MikeS11/MiSTerFPGA_YC_Encoder/Breakout Boards/BOM_JLCSMT_YC_Active_bbrd_1.0.xlsx

Comment | Designator | Footprint | JLCPCB Part #（optional）
100 nF | C1 | C0402 | C1525
150 pF | C11 | C0603 | C237333
100 nF | C2 | C0402 | C1525
0.1 nF | C3 | C0402 | C1546
100 nF | C4 | C0402 | C1525
470 pF | C5 | C0402 | C1537
82 pF | C6 | C0402 | C526982
10 pF | C7 | C0603 | C513681
Diode - 1N4148WS | D1 | SOD-323F | C2128
8.2 uH | L1 | L3225M | C295147
Dual N Type MOSFET | Q2 | SOT363 | C396098
91 | R1 | R0603 | C25199
422 | R10 | R0603 | C23170
1.4k | R15 | R0402 | C25867
10k | R16 | R0402 | C25744
10k | R17 | R0402 | C25744
100k | R18 | R0402 | C25741
10k | R2 | R0402 | C25744
75 | R3 | R0402 | C25133
75 | R4 | R0402 | C25133
75 | R5 | R0402 | C25133
75 | R6 | R0402 | C25133
430 | R7 | R0603 | C23170
160 | R8 | R0603 | C22814
820 | R9 | R0603 | C23253
N-Type MOSFET | T1 | SOT23 | C8545
BJT N-Type Dual | U2 | SOT65P210X110-6N | C513269
