MikeS11/MiSTerFPGA_YC_Encoder/Breakout Boards/YC_Active_bbrd_1.01.pdf

# MisterFPGA - Active YC Out Breakout Board Mike Simone - 2022

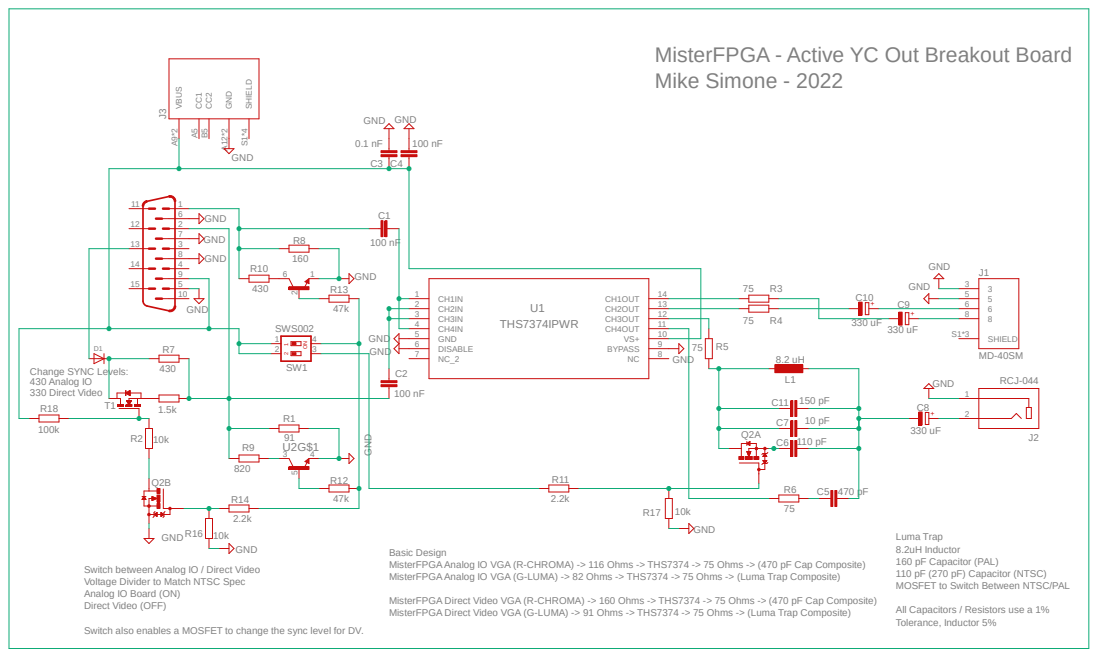
[picture p1: page 1]

Luma Trap
8.2uH Inductor
160 pF Capacitor (PAL)
110 pF (270 pF) Capacitor (NTSC)
MOSFET to Switch Between NTSC/PAL

Basic Design
MisterFPGA Analog IO VGA (R-CHROMA) -> 116 Ohms -> THS7374 -> 75 Ohms -> (470 pF Cap Composite)
MisterFPGA Analog IO VGA (G-LUMA) -> 82 Ohms -> THS7374 -> 75 Ohms -> (Luma Trap Composite)

Switch between Analog IO / Direct Video
Voltage Divider to Match NTSC Spec
Analog IO Board (ON)
Direct Video (OFF)

MisterFPGA Direct Video VGA (R-CHROMA) -> 160 Ohms -> THS7374 -> 75 Ohms -> (470 pF Cap Composite)
MisterFPGA Direct Video VGA (G-LUMA) -> 91 Ohms -> THS7374 -> 75 Ohms -> (Luma Trap Composite)

All Capacitors / Resistors use a 1%
Tolerance, Inductor 5%

Switch also enables a MOSFET to change the sync level for DV.

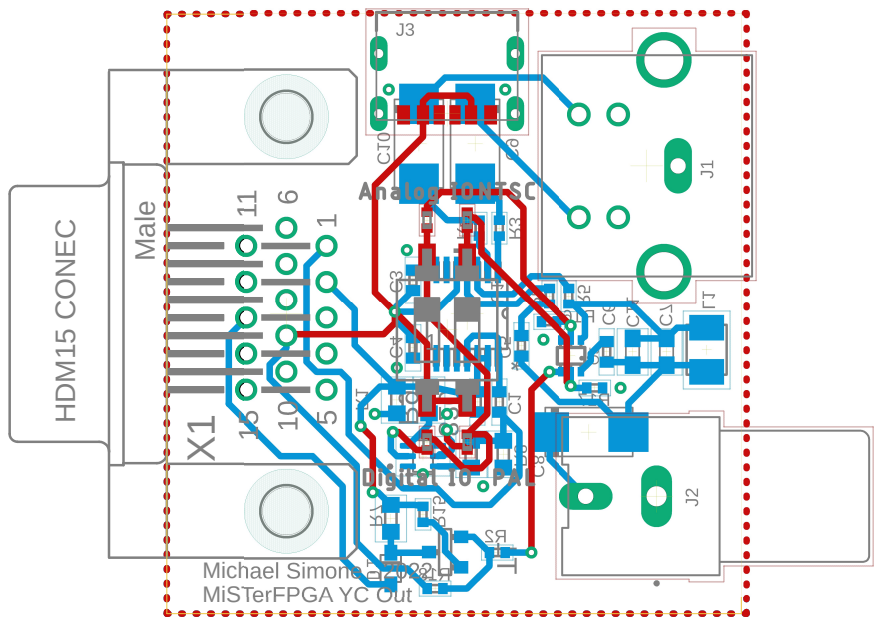
[picture p2: page 2]
15 11 Male HDM15 CONEC; Michael Simone - 2022

MiSTerFPGA YC Out X¹
