MikeS11/MiSTerFPGA_YC_Encoder/Breakout Boards/YCbbrd_1.01.pdf

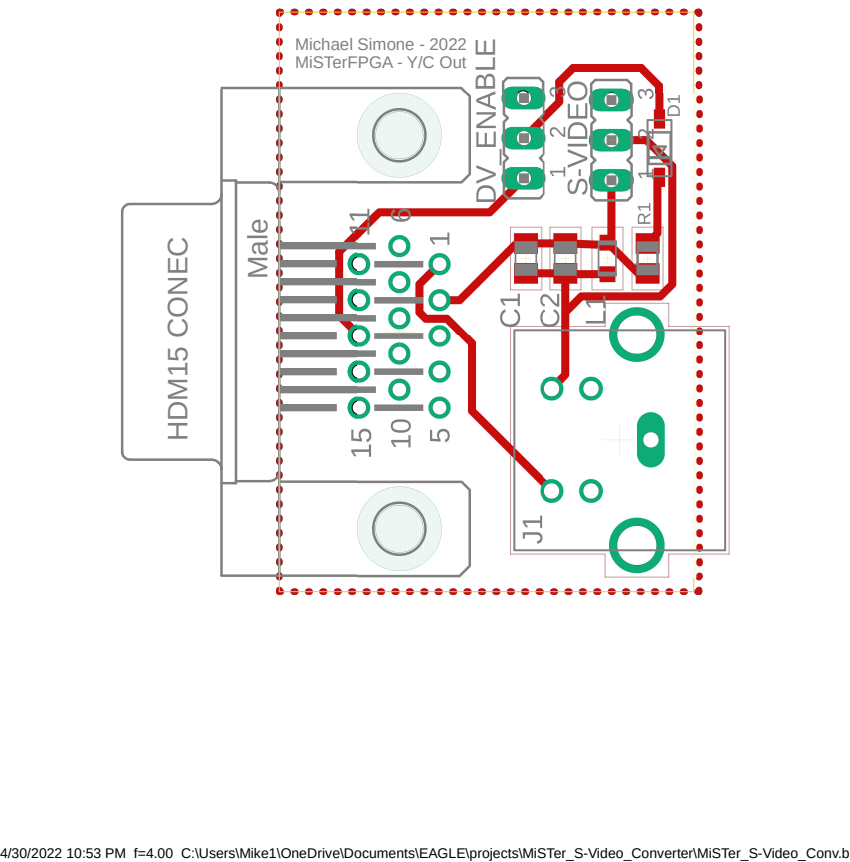
[picture p3: page 1]
3 3 HDM15 CONEC; Michael Simone - 2022 MiSTerFPGA - Y/C Out

4/30/2022 10:53 PM f=4.00 C:\Users\Mike1\OneDrive\Documents\EAGLE\projects\MiSTer_S-Video_Converter\MiSTer_S-Video_Conv.brd 15 11 Male

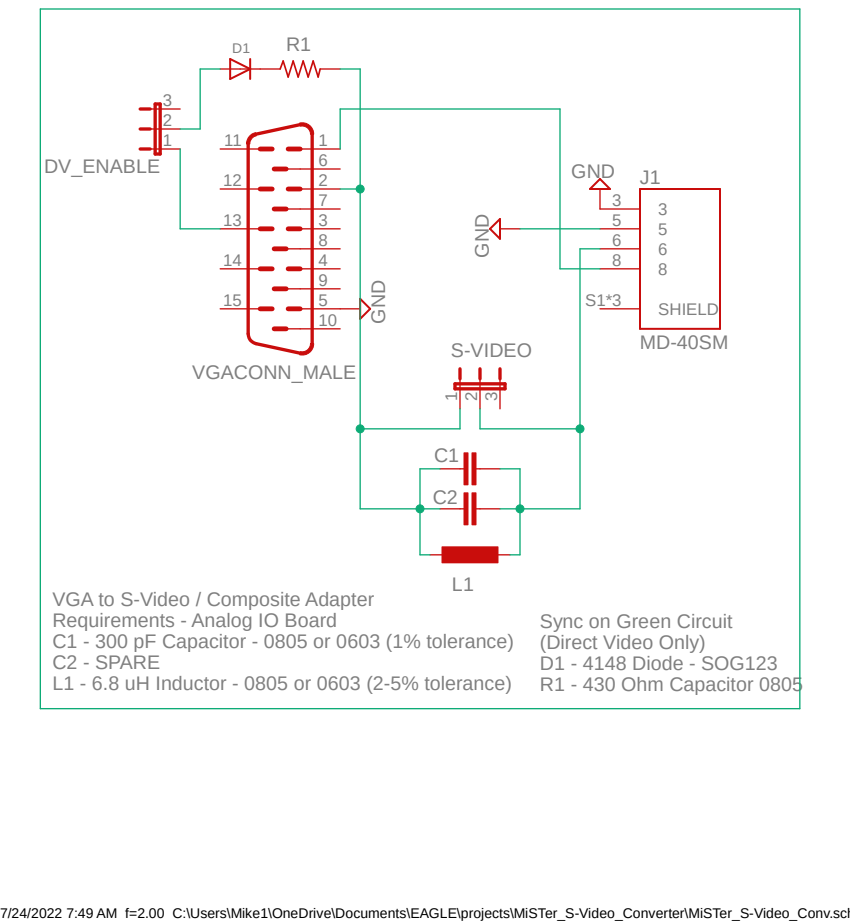
[picture p4: page 2]
MD-40SM GND; GND GND; SHIELD S1*3; VGACONN_MALE; DV_ENABLE; S-VIDEO

VGA to S-Video / Composite Adapter
Requirements - Analog IO Board
C1 - 300 pF Capacitor - 0805 or 0603 (1% tolerance)
C2 - SPARE
L1 - 6.8 uH Inductor - 0805 or 0603 (2-5% tolerance)

Sync on Green Circuit
(Direct Video Only)
D1 - 4148 Diode - SOG123
R1 - 430 Ohm Capacitor 0805

7/24/2022 7:49 AM f=2.00 C:\Users\Mike1\OneDrive\Documents\EAGLE\projects\MiSTer_S-Video_Converter\MiSTer_S-Video_Conv.sch (Sheet: 1/1)
