MikeS11/MiSTerFPGA_YC_Encoder/Template_MiSTer/mycore.sv

//============================================================================
//
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
//============================================================================

module emu
(
	//Master input clock
	input         CLK_50M,

	//Async reset from top-level module.
	//Can be used as initial reset.
	input         RESET,

	//Must be passed to hps_io module
	inout  [48:0] HPS_BUS,

	//Base video clock. Usually equals to CLK_SYS.
	output        CLK_VIDEO,

	//Multiple resolutions are supported using different CE_PIXEL rates.
	//Must be based on CLK_VIDEO
	output        CE_PIXEL,

	//Video aspect ratio for HDMI. Most retro systems have ratio 4:3.
	//if VIDEO_ARX[12] or VIDEO_ARY[12] is set then [11:0] contains scaled size instead of aspect ratio.
	output [12:0] VIDEO_ARX,
	output [12:0] VIDEO_ARY,

	output  [7:0] VGA_R,
	output  [7:0] VGA_G,
	output  [7:0] VGA_B,
	output        VGA_HS,
	output        VGA_VS,
	output        VGA_DE,    // = ~(VBlank | HBlank)
	output        VGA_F1,
	output [1:0]  VGA_SL,
	output        VGA_SCALER, // Force VGA scaler
	output        VGA_DISABLE, // analog out is off

	//Enable YC Output from the core
`ifdef MISTER_ENABLE_YC
	output [39:0] CHROMA_PHASE_INC,
    output [26:0] COLORBURST_RANGE,
	output        YC_EN,
	output        PALFLAG,
`endif

	input  [11:0] HDMI_WIDTH,
	input  [11:0] HDMI_HEIGHT,
	output        HDMI_FREEZE,

`ifdef MISTER_FB
	// Use framebuffer in DDRAM
	// FB_FORMAT:
	//    [2:0] : 011=8bpp(palette) 100=16bpp 101=24bpp 110=32bpp
	//    [3]   : 0=16bits 565 1=16bits 1555
	//    [4]   : 0=RGB  1=BGR (for 16/24/32 modes)
	//
	// FB_STRIDE either 0 (rounded to 256 bytes) or multiple of pixel size (in bytes)
	output        FB_EN,
	output  [4:0] FB_FORMAT,
	output [11:0] FB_WIDTH,
	output [11:0] FB_HEIGHT,
	output [31:0] FB_BASE,
	output [13:0] FB_STRIDE,
	input         FB_VBL,
	input         FB_LL,
	output        FB_FORCE_BLANK,

`ifdef MISTER_FB_PALETTE
	// Palette control for 8bit modes.
	// Ignored for other video modes.
	output        FB_PAL_CLK,
	output  [7:0] FB_PAL_ADDR,
	output [23:0] FB_PAL_DOUT,
	input  [23:0] FB_PAL_DIN,
	output        FB_PAL_WR,
`endif
`endif

	output        LED_USER,  // 1 - ON, 0 - OFF.

	// b[1]: 0 - LED status is system status OR'd with b[0]
	//       1 - LED status is controled solely by b[0]
	// hint: supply 2'b00 to let the system control the LED.
	output  [1:0] LED_POWER,
	output  [1:0] LED_DISK,

	// I/O board button press simulation (active high)
	// b[1]: user button
	// b[0]: osd button
	output  [1:0] BUTTONS,

	input         CLK_AUDIO, // 24.576 MHz
	output [15:0] AUDIO_L,
	output [15:0] AUDIO_R,
	output        AUDIO_S,   // 1 - signed audio samples, 0 - unsigned
	output  [1:0] AUDIO_MIX, // 0 - no mix, 1 - 25%, 2 - 50%, 3 - 100% (mono)

	//ADC
	inout   [3:0] ADC_BUS,

	//SD-SPI
	output        SD_SCK,
	output        SD_MOSI,
	input         SD_MISO,
	output        SD_CS,
	input         SD_CD,

	//High latency DDR3 RAM interface
	//Use for non-critical time purposes
	output        DDRAM_CLK,
	input         DDRAM_BUSY,
	output  [7:0] DDRAM_BURSTCNT,
	output [28:0] DDRAM_ADDR,
	input  [63:0] DDRAM_DOUT,
	input         DDRAM_DOUT_READY,
	output        DDRAM_RD,
	output [63:0] DDRAM_DIN,
	output  [7:0] DDRAM_BE,
	output        DDRAM_WE,

	//SDRAM interface with lower latency
	output        SDRAM_CLK,
	output        SDRAM_CKE,
	output [12:0] SDRAM_A,
	output  [1:0] SDRAM_BA,
	inout  [15:0] SDRAM_DQ,
	output        SDRAM_DQML,
	output        SDRAM_DQMH,
	output        SDRAM_nCS,
	output        SDRAM_nCAS,
	output        SDRAM_nRAS,
	output        SDRAM_nWE,

`ifdef MISTER_DUAL_SDRAM
	//Secondary SDRAM
	//Set all output SDRAM_* signals to Z ASAP if SDRAM2_EN is 0
	input         SDRAM2_EN,
	output        SDRAM2_CLK,
	output [12:0] SDRAM2_A,
	output  [1:0] SDRAM2_BA,
	inout  [15:0] SDRAM2_DQ,
	output        SDRAM2_nCS,
	output        SDRAM2_nCAS,
	output        SDRAM2_nRAS,
	output        SDRAM2_nWE,
`endif

	input         UART_CTS,
	output        UART_RTS,
	input         UART_RXD,
	output        UART_TXD,
	output        UART_DTR,
	input         UART_DSR,

	// Open-drain User port.
	// 0 - D+/RX
	// 1 - D-/TX
	// 2..6 - USR2..USR6
	// Set USER_OUT to 1 to read from USER_IN.
	input   [6:0] USER_IN,
	output  [6:0] USER_OUT,

	input         OSD_STATUS
);

///////// Default values for ports not used in this core /////////

assign ADC_BUS  = 'Z;
assign USER_OUT = '1;
assign {UART_RTS, UART_TXD, UART_DTR} = 0;
assign {SD_SCK, SD_MOSI, SD_CS} = 'Z;
assign {SDRAM_DQ, SDRAM_A, SDRAM_BA, SDRAM_CLK, SDRAM_CKE, SDRAM_DQML, SDRAM_DQMH, SDRAM_nWE, SDRAM_nCAS, SDRAM_nRAS, SDRAM_nCS} = 'Z;
assign {DDRAM_CLK, DDRAM_BURSTCNT, DDRAM_ADDR, DDRAM_DIN, DDRAM_BE, DDRAM_RD, DDRAM_WE} = '0;  

assign VGA_SL = 0;
assign VGA_F1 = 0;
assign VGA_SCALER  = 0;
assign VGA_DISABLE = 0;
assign HDMI_FREEZE = 0;

assign AUDIO_S = 0;
assign AUDIO_L = 0;
assign AUDIO_R = 0;
assign AUDIO_MIX = 0;

assign LED_DISK = 0;
assign LED_POWER = 0;
assign BUTTONS = 0;

//////////////////////////////////////////////////////////////////

wire [1:0] ar = status[122:121];

assign VIDEO_ARX = (!ar) ? 12'd4 : (ar - 1'd1);
assign VIDEO_ARY = (!ar) ? 12'd3 : 12'd0;

`include "build_id.v" 
localparam CONF_STR = {
	"MyCore;;",
	"-;",
	"O[122:121],Aspect ratio,Original,Full Screen,[ARC1],[ARC2];",
	"O[2],TV Mode,NTSC,PAL;",
	"O[4:3],Noise,White,Red,Green,Blue;",
//  "O[22],Video Signal,RGBS/YPbPr,Y/C;",
	"-;",
	"P1,Test Page 1;",
	"P1-;",
	"P1-, -= Options in page 1 =-;",
	"P1-;",
	"P1O[5],Option 1-1,Off,On;",
	"d0P1F1,BIN;",
	"H0P1O[10],Option 1-2,Off,On;",
	"-;",
	"P2,Test Page 2;",
	"P2-;",
	"P2-, -= Options in page 2 =-;",
	"P2-;",
	"P2S0,DSK;",
	"P2O[7:6],Option 2,1,2,3,4;",
	"-;",
	"-;",
	"T[0],Reset;",
	"R[0],Reset and close OSD;",
	"V,v",`BUILD_DATE 
};

wire forced_scandoubler;
wire   [1:0] buttons;
wire [127:0] status;
wire  [10:0] ps2_key;

hps_io #(.CONF_STR(CONF_STR)) hps_io
(
	.clk_sys(clk_sys),
	.HPS_BUS(HPS_BUS),
	.EXT_BUS(),
	.gamma_bus(),

	.forced_scandoubler(forced_scandoubler),

	.buttons(buttons),
	.status(status),
	.status_menumask({status[5]}),
	
	.ps2_key(ps2_key)
);

///////////////////////   CLOCKS   ///////////////////////////////

wire clk_sys;
pll pll
(
	.refclk(CLK_50M),
	.rst(0),
	.outclk_0(clk_sys)
);

wire reset = RESET | status[0] | buttons[1];

//////////////////////////////////////////////////////////////////

// SET PAL and NTSC TIMING and pass through status bits. ** YC must be enabled in the qsf file **
`ifdef MISTER_ENABLE_YC
	parameter NTSC_REF = 3.579545;   
	parameter PAL_REF = 4.43361875;
	// Colorburst Lenth Calculation to send to Y/C Module, based on the CLK_VIDEO of the core
	localparam [6:0] COLORBURST_START = (3.7 * (CLK_VIDEO_NTSC/NTSC_REF));
	localparam [9:0] COLORBURST_NTSC_END = (9 * (CLK_VIDEO_NTSC/NTSC_REF)) + COLORBURST_START;
	localparam [9:0] COLORBURST_PAL_END = (10 * (CLK_VIDEO_PAL/PAL_REF)) + COLORBURST_START;
 
	// Parameters to be modifed
    parameter CLK_VIDEO_NTSC = 42.3; // Must be filled E.g XX.X Hz - CLK_VIDEO
	parameter CLK_VIDEO_PAL = 42.3; // Must be filled E.g XX.X Hz - CLK_VIDEO
	localparam [39:0] NTSC_PHASE_INC = 40'd91625968981; // ((NTSC_REF**2^40) / CLK_VIDEO_NTSC) - SNES Example;
	localparam [39:0] PAL_PHASE_INC = 40'd114532461227; // ((PAL_REF*2^40) / CLK_VIDEO_PAL)- SNES Example;

	// Send Parameters to Y/C Module
	assign CHROMA_PHASE_INC = PALFLAG ? PAL_PHASE_INC : NTSC_PHASE_INC; 
	assign YC_EN = status[2];  // Change the status to match your configuration
	assign PALFLAG = status[2];  // if applicable, Change the status to match your configuration. 
 	assign COLORBURST_RANGE = {COLORBURST_START, COLORBURST_NTSC_END, COLORBURST_PAL_END}; // Pass colorburst length
`endif

wire [1:0] col = status[4:3];

wire HBlank;
wire HSync;
wire VBlank;
wire VSync;
wire ce_pix;
wire [7:0] video;

mycore mycore
(
	.clk(clk_sys),
	.reset(reset),
	
	.pal(status[2]),
	.scandouble(forced_scandoubler),

	.ce_pix(ce_pix),

	.HBlank(HBlank),
	.HSync(HSync),
	.VBlank(VBlank),
	.VSync(VSync),

	.video(video)
);

assign CLK_VIDEO = clk_sys;
assign CE_PIXEL = ce_pix;

assign VGA_DE = ~(HBlank | VBlank);
assign VGA_HS = HSync;
assign VGA_VS = VSync;
assign VGA_G  = (!col || col == 2) ? video : 8'd0;
assign VGA_R  = (!col || col == 1) ? video : 8'd0;
assign VGA_B  = (!col || col == 3) ? video : 8'd0;

reg  [26:0] act_cnt;
always @(posedge clk_sys) act_cnt <= act_cnt + 1'd1; 
assign LED_USER    = act_cnt[26]  ? act_cnt[25:18]  > act_cnt[7:0]  : act_cnt[25:18]  <= act_cnt[7:0];

endmodule
