MikeS11/MiSTerFPGA_YC_Encoder/(commit log)

2022-05-01 Added Y/C Breakout Board
    Breakout board has sync on green circuit as well as a luma trap. Both can be enabled or disabled through jumpers.
2022-05-06 Large update to all cores, Added GBA, GBC
    Improved the colorburst length which was causing some dulling of colors on some cores. Thanks to @retrorepair for the help finding this problem :+1: Also adjusted make a small shift in the colorburst signal to better match colors.
    [yc_out.sv]
2022-05-18 Updated Cores with corrections to Y/C Timing (Improved colorbleeding and saturation issues)
    Also Added VIC-20, Odyssey2, Astrocade and Arkanoid
    [yc_out.sv]
2022-07-24 YC Passive Breakout Board - Schematic Update
2022-10-02 First Revision of the Active YC Breakout Board
    - Adds an Active Amp/Filter to bring luma/chroma voltages up to NTSC Spec.
    - Updated Luma Trap
    - Added switches to change the voltages when using the Analog IO board or Direct Video through an external VGA to HDMI adapter.
    - Sync level with remain the same if you are switched between Analog IO / DV. (switches between 430 / 330 ohms)
    [BOM_JLCSMT_YC_Active_bbrd_1.0.xlsx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]
2023-06-09 Active YC Board - Update Luma Trap Values
    Updated PDF to adjust capacitor values for reference.
    270 pF greatly improve the luma trap for cores like the Genesis, where the previous value of 242 pF. Previous values were a good, and visually looked better than a stock genesis but not as good as a 32x.
