MikeS11/MiSTerFPGA_YC_Encoder/(notices)

Notices in the files:
Template_MiSTer/sys/sys_top.v:
under the terms of the GNU General Public License as published by the Free
